emilkarimov/G3_airhockey/README.md

AIR HOCKEY TABLE GAME - ECE532 April 13th 2017

The folder structure for this github is as follows:
     Docs contains the final presentation, final report, block diagram, and video demo.
     src contains the project files and IP used. 

     For details about this project, please refer to the documentation.
     For a detailed breakdown of this tree, please see the corresponding section in the final report.
     To start this project in Vivado, navigate to src/image_proc/NexysVideo-master_v3/Projects/hdmi/proj/hdmi.xpr

Authors
     Richard Lin
     Jashva Rafique
     Emil Karimov
     Prabhnoor Kainth
