emilkarimov/G3_airhockey/src/image_proc/NexysVideo-master_v3/Projects/hdmi/proj/hdmi.runs/impl_1/_init_design.begin.rst

<?xml version="1.0"?>
<ProcessHandle Version="1" Minor="0">
    <Process Command=".planAhead." Owner="dezfoul2" Host="SFB520WS14" Pid="3860">
    </Process>
</ProcessHandle>
