emilkarimov/G3_airhockey/src/image_proc/packaged-joystick/ip_repo/edit_packaged_joystick_v1_0.runs/synth_1/.vivado.begin.rst

<?xml version="1.0"?>
<ProcessHandle Version="1" Minor="0">
    <Process Command="vivado.bat" Owner="Jash" Host="JASH-PC" Pid="10768">
    </Process>
</ProcessHandle>
