emilkarimov/G3_airhockey/src/image_proc/NexysVideo-master_v3/Projects/hdmi/proj/hdmi.runs/impl_1/.vivado.begin.rst

<?xml version="1.0"?>
<ProcessHandle Version="1" Minor="0">
    <Process Command="vivado.bat" Owner="richa" Host="RLIN-GAMING" Pid="13996">
    </Process>
</ProcessHandle>
