emilkarimov/G3_airhockey/src/image_proc/NexysVideo-master_v3/Projects/hdmi/proj/hdmi.runs/impl_1/_vivado.begin.rst

<?xml version="1.0"?>
<ProcessHandle Version="1" Minor="0">
    <Process Command="vivado.bat" Owner="dezfoul2" Host="SFB520WS14" Pid="3720">
    </Process>
</ProcessHandle>
