emilkarimov/G3_airhockey/docs/hdmi.pdf

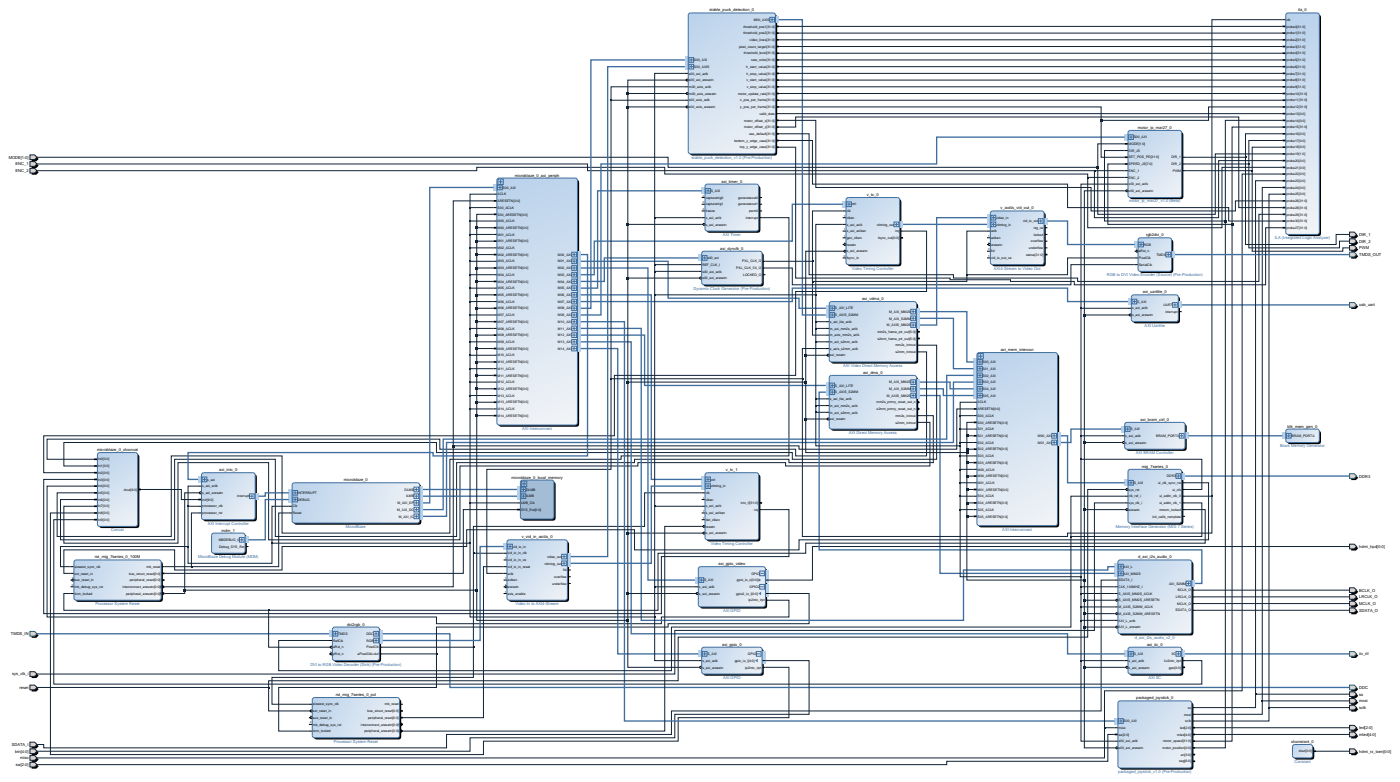
[picture p21: page 1]
BCLK_O; DDC; DDR3; DIR_1 DIR_2; ENC_1 ENC_2; LRCLK_O MCLK_O; MODE[1:0]; PWM; SDATA_I; SDATA_O; TMDS_IN; TMDS_OUT; axi_bram_ctrl_0; S_AXI s_axi_aclk; BRAM_PORTA; s_axi_aresetn; axi_dma_0; S_AXI_LITE; M_AXI_MM2S M_AXI_S2MM; M_AXIS_MM2S; S_AXIS_S2MM; s_axi_lite_aclk m_axi_mm2s_aclk m_axi_s2mm_aclk axi_resetn; mm2s_prmry_reset_out_n; s2mm_prmry_reset_out_n mm2s_introut s2mm_introut; axi_dynclk_0; s00_axi REF_CLK_I; PXL_CLK_O; PXL_CLK_5X_O; LOCKED_O; s00_axi_aclk; s00_axi_aresetn; axi_gpio_video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

S00_AXI ACLK ARESETN[0:0] S00_ACLK S00_ARESETN[0:0] M00_ACLK M00_ARESETN[0:0] M01_ACLK M01_ARESETN[0:0] M02_ACLK M02_ARESETN[0:0] M03_ACLK M03_ARESETN[0:0] M04_ACLK M04_ARESETN[0:0] M05_ACLK M05_ARESETN[0:0] M06_ACLK M06_ARESETN[0:0] M07_ACLK M07_ARESETN[0:0] M08_ACLK M08_ARESETN[0:0] M09_ACLK M09_ARESETN[0:0] M10_ACLK M10_ARESETN[0:0] M11_ACLK M11_ARESETN[0:0] M12_ACLK M12_ARESETN[0:0] M13_ACLK M13_ARESETN[0:0] M14_ACLK M14_ARESETN[0:0] M00_AXI M01_AXI M02_AXI M03_AXI M04_AXI M05_AXI M06_AXI M07_AXI M08_AXI M09_AXI M10_AXI M11_AXI M12_AXI M13_AXI M14_AXI | axi_timer_0

ILA (Integrated Logic Analyzer)

Video Timing Controller

AXI4-Stream to Video Out

Dynamic Clock Generator (Pre-Production)

RGB to DVI Video Encoder (Source) (Pre-Production)

AXI Video Direct Memory Access

AXI Direct Memory Access

AXI BRAM Controller

Block Memory Generator

AXI Interrupt Controller
mdm_1

Memory Interface Generator (MIG 7 Series)

MicroBlaze Debug Module (MDM)

Processor System Reset

Video In to AXI4-Stream

DVI to RGB Video Decoder (Sink) (Pre-Production)

ss mosi sclk

led[2:0] mled[4:0] motor_speed[31:0] motor_position[0:0] an[3:0] seg[6:0]
