emilkarimov/G3_airhockey/src/image_proc/NexysVideo-master_v3/Projects/hdmi/proj/hdmi.runs/synth_1/.Xil/hdmi_wrapper_propImpl.xdc

set_property SRC_FILE_INFO {cfile:d:/Xilinx/Projects/image_proc/NexysVideo-master_v3/Projects/hdmi/proj/hdmi.srcs/sources_1/bd/hdmi/ip/hdmi_mdm_1_0/hdmi_mdm_1_0.xdc rfile:../../../hdmi.srcs/sources_1/bd/hdmi/ip/hdmi_mdm_1_0/hdmi_mdm_1_0.xdc id:1 order:EARLY scoped_inst:hdmi_i/mdm_1/U0} [current_design]
set_property SRC_FILE_INFO {cfile:d:/Xilinx/Projects/image_proc/NexysVideo-master_v3/Projects/hdmi/proj/hdmi.srcs/sources_1/bd/hdmi/ip/hdmi_microblaze_0_0/hdmi_microblaze_0_0.xdc rfile:../../../hdmi.srcs/sources_1/bd/hdmi/ip/hdmi_microblaze_0_0/hdmi_microblaze_0_0.xdc id:2 order:EARLY scoped_inst:hdmi_i/microblaze_0/U0} [current_design]
set_property SRC_FILE_INFO {cfile:d:/Xilinx/Projects/image_proc/NexysVideo-master_v3/Projects/hdmi/proj/hdmi.srcs/sources_1/bd/hdmi/ip/hdmi_mig_7series_0_0/hdmi_mig_7series_0_0/user_design/constraints/hdmi_mig_7series_0_0.xdc rfile:../../../hdmi.srcs/sources_1/bd/hdmi/ip/hdmi_mig_7series_0_0/hdmi_mig_7series_0_0/user_design/constraints/hdmi_mig_7series_0_0.xdc id:3 order:EARLY scoped_inst:hdmi_i/mig_7series_0} [current_design]
set_property SRC_FILE_INFO {cfile:D:/Xilinx/Projects/image_proc/NexysVideo-master_v3/Projects/hdmi/src/constraints/NexysVideo_Master.xdc rfile:../../../../src/constraints/NexysVideo_Master.xdc id:4} [current_design]
set_property SRC_FILE_INFO {cfile:d:/Xilinx/Projects/image_proc/NexysVideo-master_v3/Projects/hdmi/proj/hdmi.srcs/sources_1/bd/hdmi/ip/hdmi_v_tc_0_0/hdmi_v_tc_0_0_clocks.xdc rfile:../../../hdmi.srcs/sources_1/bd/hdmi/ip/hdmi_v_tc_0_0/hdmi_v_tc_0_0_clocks.xdc id:5 order:LATE scoped_inst:hdmi_i/v_tc_0/U0} [current_design]
set_property SRC_FILE_INFO {cfile:d:/Xilinx/Projects/image_proc/NexysVideo-master_v3/Projects/hdmi/proj/hdmi.srcs/sources_1/bd/hdmi/ip/hdmi_v_tc_1_0/hdmi_v_tc_1_0_clocks.xdc rfile:../../../hdmi.srcs/sources_1/bd/hdmi/ip/hdmi_v_tc_1_0/hdmi_v_tc_1_0_clocks.xdc id:6 order:LATE scoped_inst:hdmi_i/v_tc_1/U0} [current_design]
set_property SRC_FILE_INFO {cfile:d:/Xilinx/Projects/image_proc/NexysVideo-master_v3/Projects/hdmi/proj/hdmi.srcs/sources_1/bd/hdmi/ip/hdmi_v_vid_in_axi4s_0_0/hdmi_v_vid_in_axi4s_0_0_clocks.xdc rfile:../../../hdmi.srcs/sources_1/bd/hdmi/ip/hdmi_v_vid_in_axi4s_0_0/hdmi_v_vid_in_axi4s_0_0_clocks.xdc id:7 order:LATE scoped_inst:hdmi_i/v_vid_in_axi4s_0/inst} [current_design]
set_property SRC_FILE_INFO {cfile:d:/Xilinx/Projects/image_proc/NexysVideo-master_v3/Projects/hdmi/proj/hdmi.srcs/sources_1/bd/hdmi/ip/hdmi_d_axi_i2s_audio_0_0/src/fifo_32/fifo_32/fifo_32_clocks.xdc rfile:../../../hdmi.srcs/sources_1/bd/hdmi/ip/hdmi_d_axi_i2s_audio_0_0/src/fifo_32/fifo_32/fifo_32_clocks.xdc id:8 order:LATE scoped_inst:hdmi_i/d_axi_i2s_audio_0/U0/d_axi_i2s_audio_v2_0_AXI_L_inst/Inst_I2sCtl/Inst_I2sTxFifo/U0} [current_design]
set_property SRC_FILE_INFO {cfile:d:/Xilinx/Projects/image_proc/NexysVideo-master_v3/Projects/hdmi/proj/hdmi.srcs/sources_1/bd/hdmi/ip/hdmi_d_axi_i2s_audio_0_0/src/fifo_32/fifo_32/fifo_32_clocks.xdc rfile:../../../hdmi.srcs/sources_1/bd/hdmi/ip/hdmi_d_axi_i2s_audio_0_0/src/fifo_32/fifo_32/fifo_32_clocks.xdc id:9 order:LATE scoped_inst:hdmi_i/d_axi_i2s_audio_0/U0/d_axi_i2s_audio_v2_0_AXI_L_inst/Inst_I2sCtl/Inst_I2sRxFifo/U0} [current_design]
set_property SRC_FILE_INFO {cfile:d:/Xilinx/Projects/image_proc/NexysVideo-master_v3/Projects/hdmi/proj/hdmi.srcs/sources_1/bd/hdmi/ip/hdmi_d_axi_i2s_audio_0_0/src/fifo_4/fifo_4/fifo_4_clocks.xdc rfile:../../../hdmi.srcs/sources_1/bd/hdmi/ip/hdmi_d_axi_i2s_audio_0_0/src/fifo_4/fifo_4/fifo_4_clocks.xdc id:10 order:LATE scoped_inst:hdmi_i/d_axi_i2s_audio_0/U0/d_axi_i2s_audio_v2_0_AXI_L_inst/Inst_I2sCtl/Inst_Sampling/U0} [current_design]
set_property src_info {type:SCOPED_XDC file:1 line:57 export:INPUT save:INPUT read:READ} [current_design]
set_ip_msg_config -idlist { CDC-1 CDCM-1 REQP-1851 TIMING-2 TIMING-4 TIMING-9 TIMING-10 TIMING-14 }
set_property src_info {type:SCOPED_XDC file:2 line:2 export:INPUT save:INPUT read:READ} [current_design]
set_ip_msg_config -idlist { DPOP-3 PDCN-1569 CDC-1 CDC-4 CDC-7 TIMING-9 TIMING-10 DPIP-2 DPOP-4 }
set_property src_info {type:SCOPED_XDC file:3 line:48 export:INPUT save:INPUT read:READ} [current_design]
set_property PACKAGE_PIN G2 [get_ports {ddr3_dq[0]}]
set_property src_info {type:SCOPED_XDC file:3 line:54 export:INPUT save:INPUT read:READ} [current_design]
set_property PACKAGE_PIN H4 [get_ports {ddr3_dq[1]}]
set_property src_info {type:SCOPED_XDC file:3 line:60 export:INPUT save:INPUT read:READ} [current_design]
set_property PACKAGE_PIN H5 [get_ports {ddr3_dq[2]}]
set_property src_info {type:SCOPED_XDC file:3 line:66 export:INPUT save:INPUT read:READ} [current_design]
set_property PACKAGE_PIN J1 [get_ports {ddr3_dq[3]}]
set_property src_info {type:SCOPED_XDC file:3 line:72 export:INPUT save:INPUT read:READ} [current_design]
set_property PACKAGE_PIN K1 [get_ports {ddr3_dq[4]}]
set_property src_info {type:SCOPED_XDC file:3 line:78 export:INPUT save:INPUT read:READ} [current_design]
set_property PACKAGE_PIN H3 [get_ports {ddr3_dq[5]}]
set_property src_info {type:SCOPED_XDC file:3 line:84 export:INPUT save:INPUT read:READ} [current_design]
set_property PACKAGE_PIN H2 [get_ports {ddr3_dq[6]}]
set_property src_info {type:SCOPED_XDC file:3 line:90 export:INPUT save:INPUT read:READ} [current_design]
set_property PACKAGE_PIN J5 [get_ports {ddr3_dq[7]}]
set_property src_info {type:SCOPED_XDC file:3 line:96 export:INPUT save:INPUT read:READ} [current_design]
set_property PACKAGE_PIN E3 [get_ports {ddr3_dq[8]}]
set_property src_info {type:SCOPED_XDC file:3 line:102 export:INPUT save:INPUT read:READ} [current_design]
set_property PACKAGE_PIN B2 [get_ports {ddr3_dq[9]}]
set_property src_info {type:SCOPED_XDC file:3 line:108 export:INPUT save:INPUT read:READ} [current_design]
set_property PACKAGE_PIN F3 [get_ports {ddr3_dq[10]}]
set_property src_info {type:SCOPED_XDC file:3 line:114 export:INPUT save:INPUT read:READ} [current_design]
set_property PACKAGE_PIN D2 [get_ports {ddr3_dq[11]}]
set_property src_info {type:SCOPED_XDC file:3 line:120 export:INPUT save:INPUT read:READ} [current_design]
set_property PACKAGE_PIN C2 [get_ports {ddr3_dq[12]}]
set_property src_info {type:SCOPED_XDC file:3 line:126 export:INPUT save:INPUT read:READ} [current_design]
set_property PACKAGE_PIN A1 [get_ports {ddr3_dq[13]}]
set_property src_info {type:SCOPED_XDC file:3 line:132 export:INPUT save:INPUT read:READ} [current_design]
set_property PACKAGE_PIN E2 [get_ports {ddr3_dq[14]}]
set_property src_info {type:SCOPED_XDC file:3 line:138 export:INPUT save:INPUT read:READ} [current_design]
set_property PACKAGE_PIN B1 [get_ports {ddr3_dq[15]}]
set_property src_info {type:SCOPED_XDC file:3 line:143 export:INPUT save:INPUT read:READ} [current_design]
set_property PACKAGE_PIN P6 [get_ports {ddr3_addr[14]}]
set_property src_info {type:SCOPED_XDC file:3 line:148 export:INPUT save:INPUT read:READ} [current_design]
set_property PACKAGE_PIN P2 [get_ports {ddr3_addr[13]}]
set_property src_info {type:SCOPED_XDC file:3 line:153 export:INPUT save:INPUT read:READ} [current_design]
set_property PACKAGE_PIN N4 [get_ports {ddr3_addr[12]}]
set_property src_info {type:SCOPED_XDC file:3 line:158 export:INPUT save:INPUT read:READ} [current_design]
set_property PACKAGE_PIN N5 [get_ports {ddr3_addr[11]}]
set_property src_info {type:SCOPED_XDC file:3 line:163 export:INPUT save:INPUT read:READ} [current_design]
set_property PACKAGE_PIN L5 [get_ports {ddr3_addr[10]}]
set_property src_info {type:SCOPED_XDC file:3 line:168 export:INPUT save:INPUT read:READ} [current_design]
set_property PACKAGE_PIN R1 [get_ports {ddr3_addr[9]}]
set_property src_info {type:SCOPED_XDC file:3 line:173 export:INPUT save:INPUT read:READ} [current_design]
set_property PACKAGE_PIN M6 [get_ports {ddr3_addr[8]}]
set_property src_info {type:SCOPED_XDC file:3 line:178 export:INPUT save:INPUT read:READ} [current_design]
set_property PACKAGE_PIN N2 [get_ports {ddr3_addr[7]}]
set_property src_info {type:SCOPED_XDC file:3 line:183 export:INPUT save:INPUT read:READ} [current_design]
set_property PACKAGE_PIN N3 [get_ports {ddr3_addr[6]}]
set_property src_info {type:SCOPED_XDC file:3 line:188 export:INPUT save:INPUT read:READ} [current_design]
set_property PACKAGE_PIN P1 [get_ports {ddr3_addr[5]}]
set_property src_info {type:SCOPED_XDC file:3 line:193 export:INPUT save:INPUT read:READ} [current_design]
set_property PACKAGE_PIN L6 [get_ports {ddr3_addr[4]}]
set_property src_info {type:SCOPED_XDC file:3 line:198 export:INPUT save:INPUT read:READ} [current_design]
set_property PACKAGE_PIN M1 [get_ports {ddr3_addr[3]}]
set_property src_info {type:SCOPED_XDC file:3 line:203 export:INPUT save:INPUT read:READ} [current_design]
set_property PACKAGE_PIN M3 [get_ports {ddr3_addr[2]}]
set_property src_info {type:SCOPED_XDC file:3 line:208 export:INPUT save:INPUT read:READ} [current_design]
set_property PACKAGE_PIN M5 [get_ports {ddr3_addr[1]}]
set_property src_info {type:SCOPED_XDC file:3 line:213 export:INPUT save:INPUT read:READ} [current_design]
set_property PACKAGE_PIN M2 [get_ports {ddr3_addr[0]}]
set_property src_info {type:SCOPED_XDC file:3 line:218 export:INPUT save:INPUT read:READ} [current_design]
set_property PACKAGE_PIN L4 [get_ports {ddr3_ba[2]}]
set_property src_info {type:SCOPED_XDC file:3 line:223 export:INPUT save:INPUT read:READ} [current_design]
set_property PACKAGE_PIN K6 [get_ports {ddr3_ba[1]}]
set_property src_info {type:SCOPED_XDC file:3 line:228 export:INPUT save:INPUT read:READ} [current_design]
set_property PACKAGE_PIN L3 [get_ports {ddr3_ba[0]}]
set_property src_info {type:SCOPED_XDC file:3 line:233 export:INPUT save:INPUT read:READ} [current_design]
set_property PACKAGE_PIN J4 [get_ports {ddr3_ras_n}]
set_property src_info {type:SCOPED_XDC file:3 line:238 export:INPUT save:INPUT read:READ} [current_design]
set_property PACKAGE_PIN K3 [get_ports {ddr3_cas_n}]
set_property src_info {type:SCOPED_XDC file:3 line:243 export:INPUT save:INPUT read:READ} [current_design]
set_property PACKAGE_PIN L1 [get_ports {ddr3_we_n}]
set_property src_info {type:SCOPED_XDC file:3 line:248 export:INPUT save:INPUT read:READ} [current_design]
set_property PACKAGE_PIN G1 [get_ports {ddr3_reset_n}]
set_property src_info {type:SCOPED_XDC file:3 line:253 export:INPUT save:INPUT read:READ} [current_design]
set_property PACKAGE_PIN J6 [get_ports {ddr3_cke[0]}]
set_property src_info {type:SCOPED_XDC file:3 line:258 export:INPUT save:INPUT read:READ} [current_design]
set_property PACKAGE_PIN K4 [get_ports {ddr3_odt[0]}]
set_property src_info {type:SCOPED_XDC file:3 line:263 export:INPUT save:INPUT read:READ} [current_design]
set_property PACKAGE_PIN G3 [get_ports {ddr3_dm[0]}]
set_property src_info {type:SCOPED_XDC file:3 line:268 export:INPUT save:INPUT read:READ} [current_design]
set_property PACKAGE_PIN F1 [get_ports {ddr3_dm[1]}]
set_property src_info {type:SCOPED_XDC file:3 line:272 export:INPUT save:INPUT read:READ} [current_design]
set_property PACKAGE_PIN R4 [get_ports {sys_clk_i}]
set_property src_info {type:SCOPED_XDC file:3 line:278 export:INPUT save:INPUT read:READ} [current_design]
set_property PACKAGE_PIN K2 [get_ports {ddr3_dqs_p[0]}]
set_property src_info {type:SCOPED_XDC file:3 line:284 export:INPUT save:INPUT read:READ} [current_design]
set_property PACKAGE_PIN J2 [get_ports {ddr3_dqs_n[0]}]
set_property src_info {type:SCOPED_XDC file:3 line:290 export:INPUT save:INPUT read:READ} [current_design]
set_property PACKAGE_PIN E1 [get_ports {ddr3_dqs_p[1]}]
set_property src_info {type:SCOPED_XDC file:3 line:296 export:INPUT save:INPUT read:READ} [current_design]
set_property PACKAGE_PIN D1 [get_ports {ddr3_dqs_n[1]}]
set_property src_info {type:SCOPED_XDC file:3 line:301 export:INPUT save:INPUT read:READ} [current_design]
set_property PACKAGE_PIN P5 [get_ports {ddr3_ck_p[0]}]
set_property src_info {type:SCOPED_XDC file:3 line:306 export:INPUT save:INPUT read:READ} [current_design]
set_property PACKAGE_PIN P4 [get_ports {ddr3_ck_n[0]}]
set_property src_info {type:SCOPED_XDC file:3 line:311 export:INPUT save:INPUT read:READ} [current_design]
set_property LOC PHASER_OUT_PHY_X1Y13 [get_cells  -hier -filter {NAME =~ */ddr_phy_4lanes_0.u_ddr_phy_4lanes/ddr_byte_lane_B.ddr_byte_lane_B/phaser_out}]
set_property src_info {type:SCOPED_XDC file:3 line:312 export:INPUT save:INPUT read:READ} [current_design]
set_property LOC PHASER_OUT_PHY_X1Y12 [get_cells  -hier -filter {NAME =~ */ddr_phy_4lanes_0.u_ddr_phy_4lanes/ddr_byte_lane_A.ddr_byte_lane_A/phaser_out}]
set_property src_info {type:SCOPED_XDC file:3 line:313 export:INPUT save:INPUT read:READ} [current_design]
set_property LOC PHASER_OUT_PHY_X1Y15 [get_cells  -hier -filter {NAME =~ */ddr_phy_4lanes_0.u_ddr_phy_4lanes/ddr_byte_lane_D.ddr_byte_lane_D/phaser_out}]
set_property src_info {type:SCOPED_XDC file:3 line:314 export:INPUT save:INPUT read:READ} [current_design]
set_property LOC PHASER_OUT_PHY_X1Y14 [get_cells  -hier -filter {NAME =~ */ddr_phy_4lanes_0.u_ddr_phy_4lanes/ddr_byte_lane_C.ddr_byte_lane_C/phaser_out}]
set_property src_info {type:SCOPED_XDC file:3 line:318 export:INPUT save:INPUT read:READ} [current_design]
set_property LOC PHASER_IN_PHY_X1Y15 [get_cells  -hier -filter {NAME =~ */ddr_phy_4lanes_0.u_ddr_phy_4lanes/ddr_byte_lane_D.ddr_byte_lane_D/phaser_in_gen.phaser_in}]
set_property src_info {type:SCOPED_XDC file:3 line:319 export:INPUT save:INPUT read:READ} [current_design]
set_property LOC PHASER_IN_PHY_X1Y14 [get_cells  -hier -filter {NAME =~ */ddr_phy_4lanes_0.u_ddr_phy_4lanes/ddr_byte_lane_C.ddr_byte_lane_C/phaser_in_gen.phaser_in}]
set_property src_info {type:SCOPED_XDC file:3 line:323 export:INPUT save:INPUT read:READ} [current_design]
set_property LOC OUT_FIFO_X1Y13 [get_cells  -hier -filter {NAME =~ */ddr_phy_4lanes_0.u_ddr_phy_4lanes/ddr_byte_lane_B.ddr_byte_lane_B/out_fifo}]
set_property src_info {type:SCOPED_XDC file:3 line:324 export:INPUT save:INPUT read:READ} [current_design]
set_property LOC OUT_FIFO_X1Y12 [get_cells  -hier -filter {NAME =~ */ddr_phy_4lanes_0.u_ddr_phy_4lanes/ddr_byte_lane_A.ddr_byte_lane_A/out_fifo}]
set_property src_info {type:SCOPED_XDC file:3 line:325 export:INPUT save:INPUT read:READ} [current_design]
set_property LOC OUT_FIFO_X1Y15 [get_cells  -hier -filter {NAME =~ */ddr_phy_4lanes_0.u_ddr_phy_4lanes/ddr_byte_lane_D.ddr_byte_lane_D/out_fifo}]
set_property src_info {type:SCOPED_XDC file:3 line:326 export:INPUT save:INPUT read:READ} [current_design]
set_property LOC OUT_FIFO_X1Y14 [get_cells  -hier -filter {NAME =~ */ddr_phy_4lanes_0.u_ddr_phy_4lanes/ddr_byte_lane_C.ddr_byte_lane_C/out_fifo}]
set_property src_info {type:SCOPED_XDC file:3 line:328 export:INPUT save:INPUT read:READ} [current_design]
set_property LOC IN_FIFO_X1Y15 [get_cells  -hier -filter {NAME =~ */ddr_phy_4lanes_0.u_ddr_phy_4lanes/ddr_byte_lane_D.ddr_byte_lane_D/in_fifo_gen.in_fifo}]
set_property src_info {type:SCOPED_XDC file:3 line:329 export:INPUT save:INPUT read:READ} [current_design]
set_property LOC IN_FIFO_X1Y14 [get_cells  -hier -filter {NAME =~ */ddr_phy_4lanes_0.u_ddr_phy_4lanes/ddr_byte_lane_C.ddr_byte_lane_C/in_fifo_gen.in_fifo}]
set_property src_info {type:SCOPED_XDC file:3 line:331 export:INPUT save:INPUT read:READ} [current_design]
set_property LOC PHY_CONTROL_X1Y3 [get_cells  -hier -filter {NAME =~ */ddr_phy_4lanes_0.u_ddr_phy_4lanes/phy_control_i}]
set_property src_info {type:SCOPED_XDC file:3 line:333 export:INPUT save:INPUT read:READ} [current_design]
set_property LOC PHASER_REF_X1Y3 [get_cells  -hier -filter {NAME =~ */ddr_phy_4lanes_0.u_ddr_phy_4lanes/phaser_ref_i}]
set_property src_info {type:SCOPED_XDC file:3 line:335 export:INPUT save:INPUT read:READ} [current_design]
set_property LOC OLOGIC_X1Y193 [get_cells  -hier -filter {NAME =~ */ddr_phy_4lanes_0.u_ddr_phy_4lanes/ddr_byte_lane_D.ddr_byte_lane_D/ddr_byte_group_io/*slave_ts}]
set_property src_info {type:SCOPED_XDC file:3 line:336 export:INPUT save:INPUT read:READ} [current_design]
set_property LOC OLOGIC_X1Y181 [get_cells  -hier -filter {NAME =~ */ddr_phy_4lanes_0.u_ddr_phy_4lanes/ddr_byte_lane_C.ddr_byte_lane_C/ddr_byte_group_io/*slave_ts}]
set_property src_info {type:SCOPED_XDC file:3 line:338 export:INPUT save:INPUT read:READ} [current_design]
set_property LOC PLLE2_ADV_X1Y3 [get_cells -hier -filter {NAME =~ */u_ddr3_infrastructure/plle2_i}]
set_property src_info {type:SCOPED_XDC file:3 line:339 export:INPUT save:INPUT read:READ} [current_design]
set_property LOC MMCME2_ADV_X1Y3 [get_cells -hier -filter {NAME =~ */u_ddr3_infrastructure/gen_ui_extra_clocks.mmcm_i}]
set_property src_info {type:SCOPED_XDC file:3 line:355 export:INPUT save:INPUT read:READ} [current_design]
set_max_delay -datapath_only -from [get_cells -hier -filter {NAME =~ *temp_mon_enabled.u_tempmon/* && IS_SEQUENTIAL}] -to [get_cells -hier -filter {NAME =~ *temp_mon_enabled.u_tempmon/device_temp_sync_r1*}] 20
set_property src_info {type:SCOPED_XDC file:3 line:356 export:INPUT save:INPUT read:READ} [current_design]
set_max_delay -from [get_cells -hier *rstdiv0_sync_r1_reg*] -to [get_pins -filter {NAME =~ */RESET} -of [get_cells -hier -filter {REF_NAME == PHY_CONTROL}]] -datapath_only 5
set_property src_info {type:SCOPED_XDC file:3 line:359 export:INPUT save:INPUT read:READ} [current_design]
set_max_delay -datapath_only -from [get_cells -hier -filter {NAME =~ *ddr3_infrastructure/rstdiv0_sync_r1_reg*}] -to [get_cells -hier -filter {NAME =~ *temp_mon_enabled.u_tempmon/xadc_supplied_temperature.rst_r1*}] 20
set_property src_info {type:XDC file:4 line:8 export:INPUT save:INPUT read:READ} [current_design]
set_property -dict { PACKAGE_PIN R4    IOSTANDARD LVCMOS33 } [get_ports { sys_clk_i }]; #IO_L13P_T2_MRCC_34 Sch=sysclk
set_property src_info {type:XDC file:4 line:13 export:INPUT save:INPUT read:READ} [current_design]
set_property -dict { PACKAGE_PIN T14   IOSTANDARD LVCMOS25 } [get_ports { mled[0] }]; #IO_L15P_T2_DQS_13 Sch=led[0]
set_property src_info {type:XDC file:4 line:14 export:INPUT save:INPUT read:READ} [current_design]
set_property -dict { PACKAGE_PIN T15   IOSTANDARD LVCMOS25 } [get_ports { mled[1] }]; #IO_L15N_T2_DQS_13 Sch=led[1]
set_property src_info {type:XDC file:4 line:15 export:INPUT save:INPUT read:READ} [current_design]
set_property -dict { PACKAGE_PIN T16   IOSTANDARD LVCMOS25 } [get_ports { mled[2] }]; #IO_L17P_T2_13 Sch=led[2]
set_property src_info {type:XDC file:4 line:16 export:INPUT save:INPUT read:READ} [current_design]
set_property -dict { PACKAGE_PIN U16   IOSTANDARD LVCMOS25 } [get_ports { mled[3] }]; #IO_L17N_T2_13 Sch=led[3]
set_property src_info {type:XDC file:4 line:17 export:INPUT save:INPUT read:READ} [current_design]
set_property -dict { PACKAGE_PIN V15   IOSTANDARD LVCMOS25 } [get_ports { mled[4] }]; #IO_L14N_T2_SRCC_13 Sch=led[4]
set_property src_info {type:XDC file:4 line:18 export:INPUT save:INPUT read:READ} [current_design]
set_property -dict { PACKAGE_PIN W16   IOSTANDARD LVCMOS25 } [get_ports { led[0] }]; #IO_L16N_T2_13 Sch=led[5]
set_property src_info {type:XDC file:4 line:19 export:INPUT save:INPUT read:READ} [current_design]
set_property -dict { PACKAGE_PIN W15   IOSTANDARD LVCMOS25 } [get_ports { led[1] }]; #IO_L16P_T2_13 Sch=led[6]
set_property src_info {type:XDC file:4 line:20 export:INPUT save:INPUT read:READ} [current_design]
set_property -dict { PACKAGE_PIN Y13   IOSTANDARD LVCMOS25 } [get_ports { led[2] }]; #IO_L5P_T0_13 Sch=led[7]
set_property src_info {type:XDC file:4 line:24 export:INPUT save:INPUT read:READ} [current_design]
set_property -dict { PACKAGE_PIN B22 IOSTANDARD LVCMOS12 } [get_ports { btn[4] }]; #IO_L20N_T3_16 Sch=btnc
set_property src_info {type:XDC file:4 line:25 export:INPUT save:INPUT read:READ} [current_design]
set_property -dict { PACKAGE_PIN D22 IOSTANDARD LVCMOS12 } [get_ports { btn[3] }]; #IO_L22N_T3_16 Sch=btnd
set_property src_info {type:XDC file:4 line:26 export:INPUT save:INPUT read:READ} [current_design]
set_property -dict { PACKAGE_PIN C22 IOSTANDARD LVCMOS12 } [get_ports { btn[2] }]; #IO_L20P_T3_16 Sch=btnl
set_property src_info {type:XDC file:4 line:27 export:INPUT save:INPUT read:READ} [current_design]
set_property -dict { PACKAGE_PIN D14 IOSTANDARD LVCMOS12 } [get_ports { btn[1] }]; #IO_L6P_T0_16 Sch=btnr
set_property src_info {type:XDC file:4 line:28 export:INPUT save:INPUT read:READ} [current_design]
set_property -dict { PACKAGE_PIN F15 IOSTANDARD LVCMOS12 } [get_ports { btn[0] }]; #IO_0_16 Sch=btnu
set_property src_info {type:XDC file:4 line:33 export:INPUT save:INPUT read:READ} [current_design]
set_property -dict { PACKAGE_PIN E22  IOSTANDARD LVCMOS12} [get_ports { sw[0] }]; #IO_L22P_T3_16 Sch=sw[0]
set_property src_info {type:XDC file:4 line:34 export:INPUT save:INPUT read:READ} [current_design]
set_property -dict { PACKAGE_PIN F21  IOSTANDARD LVCMOS12} [get_ports { sw[1] }]; #IO_25_16 Sch=sw[1]
set_property src_info {type:XDC file:4 line:35 export:INPUT save:INPUT read:READ} [current_design]
set_property -dict { PACKAGE_PIN G21  IOSTANDARD LVCMOS12} [get_ports { sw[2] }]; #IO_L24P_T3_16 Sch=sw[2]
set_property src_info {type:XDC file:4 line:36 export:INPUT save:INPUT read:READ} [current_design]
set_property -dict { PACKAGE_PIN G22  IOSTANDARD LVCMOS12} [get_ports { RESETN }]; #IO_L24N_T3_16 Sch=sw[3]
set_property src_info {type:XDC file:4 line:37 export:INPUT save:INPUT read:READ} [current_design]
set_property -dict { PACKAGE_PIN H17  IOSTANDARD LVCMOS12} [get_ports { GO }]; #IO_L6P_T0_15 Sch=sw[4]
set_property src_info {type:XDC file:4 line:38 export:INPUT save:INPUT read:READ} [current_design]
set_property -dict { PACKAGE_PIN J16  IOSTANDARD LVCMOS12} [get_ports { MODE[0] }]; #IO_0_15 Sch=sw[5]
set_property src_info {type:XDC file:4 line:39 export:INPUT save:INPUT read:READ} [current_design]
set_property -dict { PACKAGE_PIN K13  IOSTANDARD LVCMOS12} [get_ports { MODE[1] }]; #IO_L19P_T3_A22_15 Sch=sw[6]
set_property src_info {type:XDC file:4 line:40 export:INPUT save:INPUT read:READ} [current_design]
set_property -dict { PACKAGE_PIN M17  IOSTANDARD LVCMOS12} [get_ports { rst }]; #IO_25_15 Sch=sw[7]
set_property src_info {type:XDC file:4 line:54 export:INPUT save:INPUT read:READ} [current_design]
set_property -dict { PACKAGE_PIN W4    IOSTANDARD TMDS_33     } [get_ports { TMDS_IN_clk_n }]; #IO_L12N_T1_MRCC_34 Sch=hdmi_rx_clk_n
set_property src_info {type:XDC file:4 line:55 export:INPUT save:INPUT read:READ} [current_design]
set_property -dict { PACKAGE_PIN V4    IOSTANDARD TMDS_33     } [get_ports { TMDS_IN_clk_p }]; #IO_L12P_T1_MRCC_34 Sch=hdmi_rx_clk_p
set_property src_info {type:XDC file:4 line:57 export:INPUT save:INPUT read:READ} [current_design]
set_property -dict { PACKAGE_PIN AB12  IOSTANDARD LVCMOS25 } [get_ports { hdmi_hpd }]; #IO_L7N_T1_13 Sch=hdmi_rx_hpa
set_property src_info {type:XDC file:4 line:58 export:INPUT save:INPUT read:READ} [current_design]
set_property -dict { PACKAGE_PIN Y4    IOSTANDARD LVCMOS33 } [get_ports { ddc_scl_io }]; #IO_L11P_T1_SRCC_34 Sch=hdmi_rx_scl
set_property src_info {type:XDC file:4 line:59 export:INPUT save:INPUT read:READ} [current_design]
set_property -dict { PACKAGE_PIN AB5   IOSTANDARD LVCMOS33 } [get_ports { ddc_sda_io }]; #IO_L10N_T1_34 Sch=hdmi_rx_sda
set_property src_info {type:XDC file:4 line:60 export:INPUT save:INPUT read:READ} [current_design]
set_property -dict { PACKAGE_PIN R3    IOSTANDARD LVCMOS33 } [get_ports { hdmi_rx_txen }]; #IO_L3P_T0_DQS_34 Sch=hdmi_rx_txen
set_property src_info {type:XDC file:4 line:61 export:INPUT save:INPUT read:READ} [current_design]
set_property -dict { PACKAGE_PIN AA3   IOSTANDARD TMDS_33     } [get_ports { TMDS_IN_data_n[0] }]; #IO_L9N_T1_DQS_34 Sch=hdmi_rx_n[0]
set_property src_info {type:XDC file:4 line:62 export:INPUT save:INPUT read:READ} [current_design]
set_property -dict { PACKAGE_PIN Y3    IOSTANDARD TMDS_33     } [get_ports { TMDS_IN_data_p[0] }]; #IO_L9P_T1_DQS_34 Sch=hdmi_rx_p[0]
set_property src_info {type:XDC file:4 line:63 export:INPUT save:INPUT read:READ} [current_design]
set_property -dict { PACKAGE_PIN Y2    IOSTANDARD TMDS_33     } [get_ports { TMDS_IN_data_n[1] }]; #IO_L4N_T0_34 Sch=hdmi_rx_n[1]
set_property src_info {type:XDC file:4 line:64 export:INPUT save:INPUT read:READ} [current_design]
set_property -dict { PACKAGE_PIN W2    IOSTANDARD TMDS_33     } [get_ports { TMDS_IN_data_p[1] }]; #IO_L4P_T0_34 Sch=hdmi_rx_p[1]
set_property src_info {type:XDC file:4 line:65 export:INPUT save:INPUT read:READ} [current_design]
set_property -dict { PACKAGE_PIN V2    IOSTANDARD TMDS_33     } [get_ports { TMDS_IN_data_n[2] }]; #IO_L2N_T0_34 Sch=hdmi_rx_n[2]
set_property src_info {type:XDC file:4 line:66 export:INPUT save:INPUT read:READ} [current_design]
set_property -dict { PACKAGE_PIN U2    IOSTANDARD TMDS_33     } [get_ports { TMDS_IN_data_p[2] }]; #IO_L2P_T0_34 Sch=hdmi_rx_p[2]
set_property src_info {type:XDC file:4 line:71 export:INPUT save:INPUT read:READ} [current_design]
set_property -dict { PACKAGE_PIN U1    IOSTANDARD TMDS_33     } [get_ports { TMDS_OUT_clk_n }]; #IO_L1N_T0_34 Sch=hdmi_tx_clk_n
set_property src_info {type:XDC file:4 line:72 export:INPUT save:INPUT read:READ} [current_design]
set_property -dict { PACKAGE_PIN T1    IOSTANDARD TMDS_33     } [get_ports { TMDS_OUT_clk_p }]; #IO_L1P_T0_34 Sch=hdmi_tx_clk_p
set_property src_info {type:XDC file:4 line:76 export:INPUT save:INPUT read:READ} [current_design]
set_property -dict { PACKAGE_PIN Y1    IOSTANDARD TMDS_33     } [get_ports { TMDS_OUT_data_n[0] }]; #IO_L5N_T0_34 Sch=hdmi_tx_n[0]
set_property src_info {type:XDC file:4 line:77 export:INPUT save:INPUT read:READ} [current_design]
set_property -dict { PACKAGE_PIN W1    IOSTANDARD TMDS_33     } [get_ports { TMDS_OUT_data_p[0] }]; #IO_L5P_T0_34 Sch=hdmi_tx_p[0]
set_property src_info {type:XDC file:4 line:78 export:INPUT save:INPUT read:READ} [current_design]
set_property -dict { PACKAGE_PIN AB1   IOSTANDARD TMDS_33     } [get_ports { TMDS_OUT_data_n[1] }]; #IO_L7N_T1_34 Sch=hdmi_tx_n[1]
set_property src_info {type:XDC file:4 line:79 export:INPUT save:INPUT read:READ} [current_design]
set_property -dict { PACKAGE_PIN AA1   IOSTANDARD TMDS_33     } [get_ports { TMDS_OUT_data_p[1] }]; #IO_L7P_T1_34 Sch=hdmi_tx_p[1]
set_property src_info {type:XDC file:4 line:80 export:INPUT save:INPUT read:READ} [current_design]
set_property -dict { PACKAGE_PIN AB2   IOSTANDARD TMDS_33     } [get_ports { TMDS_OUT_data_n[2] }]; #IO_L8N_T1_34 Sch=hdmi_tx_n[2]
set_property src_info {type:XDC file:4 line:81 export:INPUT save:INPUT read:READ} [current_design]
set_property -dict { PACKAGE_PIN AB3   IOSTANDARD TMDS_33     } [get_ports { TMDS_OUT_data_p[2] }]; #IO_L8P_T1_34 Sch=hdmi_tx_p[2]
set_property src_info {type:XDC file:4 line:93 export:INPUT save:INPUT read:READ} [current_design]
set_property -dict { PACKAGE_PIN T4    IOSTANDARD LVCMOS33 } [get_ports { SDATA_I }]; #IO_L13N_T2_MRCC_34 Sch=ac_adc_sdata
set_property src_info {type:XDC file:4 line:94 export:INPUT save:INPUT read:READ} [current_design]
set_property -dict { PACKAGE_PIN T5    IOSTANDARD LVCMOS33 } [get_ports { BCLK_O }]; #IO_L14P_T2_SRCC_34 Sch=ac_bclk
set_property src_info {type:XDC file:4 line:95 export:INPUT save:INPUT read:READ} [current_design]
set_property -dict { PACKAGE_PIN W6    IOSTANDARD LVCMOS33 } [get_ports { SDATA_O }]; #IO_L15P_T2_DQS_34 Sch=ac_dac_sdata
set_property src_info {type:XDC file:4 line:96 export:INPUT save:INPUT read:READ} [current_design]
set_property -dict { PACKAGE_PIN U5    IOSTANDARD LVCMOS33 } [get_ports { LRCLK_O }]; #IO_L14N_T2_SRCC_34 Sch=ac_lrclk
set_property src_info {type:XDC file:4 line:97 export:INPUT save:INPUT read:READ} [current_design]
set_property -dict { PACKAGE_PIN U6    IOSTANDARD LVCMOS33 } [get_ports { MCLK_O }]; #IO_L16P_T2_34 Sch=ac_mclk
set_property src_info {type:XDC file:4 line:101 export:INPUT save:INPUT read:READ} [current_design]
set_property -dict { PACKAGE_PIN AB22  IOSTANDARD LVCMOS33 } [get_ports { ss }]; #IO_L10N_T1_D15_14 Sch=ja[1]
set_property src_info {type:XDC file:4 line:102 export:INPUT save:INPUT read:READ} [current_design]
set_property -dict { PACKAGE_PIN AB21  IOSTANDARD LVCMOS33 } [get_ports { mosi }]; #IO_L10P_T1_D14_14 Sch=ja[2]
set_property src_info {type:XDC file:4 line:103 export:INPUT save:INPUT read:READ} [current_design]
set_property -dict { PACKAGE_PIN AB20  IOSTANDARD LVCMOS33 } [get_ports { miso }]; #IO_L15N_T2_DQS_DOUT_CSO_B_14 Sch=ja[3]
set_property src_info {type:XDC file:4 line:104 export:INPUT save:INPUT read:READ} [current_design]
set_property -dict { PACKAGE_PIN AB18  IOSTANDARD LVCMOS33 } [get_ports { sclk }]; #IO_L17N_T2_A13_D29_14 Sch=ja[4]
set_property src_info {type:XDC file:4 line:113 export:INPUT save:INPUT read:READ} [current_design]
set_property -dict { PACKAGE_PIN V8    IOSTANDARD LVCMOS33 } [get_ports { PWM }]; #IO_L21N_T3_DQS_34 Sch=jb_n[1]
set_property src_info {type:XDC file:4 line:114 export:INPUT save:INPUT read:READ} [current_design]
set_property -dict { PACKAGE_PIN V7    IOSTANDARD LVCMOS33 } [get_ports { DIR_2 }]; #IO_L19P_T3_34 Sch=jb_p[2]
set_property src_info {type:XDC file:4 line:115 export:INPUT save:INPUT read:READ} [current_design]
set_property -dict { PACKAGE_PIN W7    IOSTANDARD LVCMOS33 } [get_ports { DIR_1 }]; #IO_L19N_T3_VREF_34 Sch=jb_n[2]
set_property src_info {type:XDC file:4 line:118 export:INPUT save:INPUT read:READ} [current_design]
set_property -dict { PACKAGE_PIN Y8    IOSTANDARD LVCMOS33 } [get_ports { ENC_2 }]; #IO_L23P_T3_34 Sch=jb_p[4]
set_property src_info {type:XDC file:4 line:119 export:INPUT save:INPUT read:READ} [current_design]
set_property -dict { PACKAGE_PIN Y7    IOSTANDARD LVCMOS33 } [get_ports { ENC_1 }]; #IO_L23N_T3_34 Sch=jb_n[4]
set_property src_info {type:XDC file:4 line:204 export:INPUT save:INPUT read:READ} [current_design]
set_property -dict { PACKAGE_PIN W5    IOSTANDARD LVCMOS33 } [get_ports { iic_rtl_scl_io }]; #IO_L15N_T2_DQS_34 Sch=scl
set_property src_info {type:XDC file:4 line:205 export:INPUT save:INPUT read:READ} [current_design]
set_property -dict { PACKAGE_PIN V5    IOSTANDARD LVCMOS33 } [get_ports { iic_rtl_sda_io }]; #IO_L16N_T2_34 Sch=sda
set_property src_info {type:SCOPED_XDC file:5 line:5 export:INPUT save:INPUT read:READ} [current_design]
set_max_delay -from [get_clocks -of_objects [get_pins hdmi_i/v_tc_0/U0/clk]] -to [all_registers -clock [get_clocks -of_objects [get_pins hdmi_i/v_tc_0/U0/s_axi_aclk]]] -datapath_only [get_property -min PERIOD [get_clocks -of_objects [get_pins hdmi_i/v_tc_0/U0/clk]]]
set_property src_info {type:SCOPED_XDC file:5 line:6 export:INPUT save:INPUT read:READ} [current_design]
set_max_delay -from [get_clocks -of_objects [get_pins hdmi_i/v_tc_0/U0/s_axi_aclk]] -to [all_registers -clock [get_clocks -of_objects [get_pins hdmi_i/v_tc_0/U0/clk]]] -datapath_only [get_property -min PERIOD [get_clocks -of_objects [get_pins hdmi_i/v_tc_0/U0/s_axi_aclk]]]
set_property src_info {type:SCOPED_XDC file:6 line:5 export:INPUT save:INPUT read:READ} [current_design]
set_max_delay -from [get_clocks -of_objects [get_pins hdmi_i/v_tc_1/U0/clk]] -to [all_registers -clock [get_clocks -of_objects [get_pins hdmi_i/v_tc_1/U0/s_axi_aclk]]] -datapath_only [get_property -min PERIOD [get_clocks -of_objects [get_pins hdmi_i/v_tc_1/U0/clk]]]
set_property src_info {type:SCOPED_XDC file:6 line:6 export:INPUT save:INPUT read:READ} [current_design]
set_max_delay -from [get_clocks -of_objects [get_pins hdmi_i/v_tc_1/U0/s_axi_aclk]] -to [all_registers -clock [get_clocks -of_objects [get_pins hdmi_i/v_tc_1/U0/clk]]] -datapath_only [get_property -min PERIOD [get_clocks -of_objects [get_pins hdmi_i/v_tc_1/U0/s_axi_aclk]]]
set_property src_info {type:SCOPED_XDC file:7 line:10 export:INPUT save:INPUT read:READ} [current_design]
set_max_delay -from [get_cells COUPLER_INST/FIFO_INST/inst_fifo_gen/gconvfifo.rf/grf.rf/gntv_or_sync_fifo.gcx.clkx/rd_pntr_gc_reg[*]] -to [get_cells COUPLER_INST/FIFO_INST/inst_fifo_gen/gconvfifo.rf/grf.rf/gntv_or_sync_fifo.gcx.clkx/gsync_stage[*].wr_stg_inst/Q_reg_reg[*]] -datapath_only [get_property -min PERIOD [get_clocks -of_objects [get_pins hdmi_i/v_vid_in_axi4s_0/inst/aclk]]]
set_property src_info {type:SCOPED_XDC file:7 line:11 export:INPUT save:INPUT read:READ} [current_design]
set_max_delay -from [get_cells COUPLER_INST/FIFO_INST/inst_fifo_gen/gconvfifo.rf/grf.rf/gntv_or_sync_fifo.gcx.clkx/wr_pntr_gc_reg[*]] -to [get_cells COUPLER_INST/FIFO_INST/inst_fifo_gen/gconvfifo.rf/grf.rf/gntv_or_sync_fifo.gcx.clkx/gsync_stage[*].rd_stg_inst/Q_reg_reg[*]] -datapath_only [get_property -min PERIOD [get_clocks -of_objects [get_pins hdmi_i/v_vid_in_axi4s_0/inst/vid_io_in_clk]]]
set_property src_info {type:SCOPED_XDC file:8 line:59 export:INPUT save:INPUT read:READ} [current_design]
set_max_delay -from [get_cells inst_fifo_gen/gconvfifo.rf/grf.rf/gntv_or_sync_fifo.gcx.clkx/rd_pntr_gc_reg[*]] -to [get_cells inst_fifo_gen/gconvfifo.rf/grf.rf/gntv_or_sync_fifo.gcx.clkx/gsync_stage[*].wr_stg_inst/Q_reg_reg[*]] -datapath_only [get_property -min PERIOD [get_clocks -of_objects [get_pins hdmi_i/d_axi_i2s_audio_0/U0/d_axi_i2s_audio_v2_0_AXI_L_inst/Inst_I2sCtl/Inst_I2sTxFifo/U0/rd_clk]]]
set_property src_info {type:SCOPED_XDC file:8 line:61 export:INPUT save:INPUT read:READ} [current_design]
set_max_delay -from [get_cells inst_fifo_gen/gconvfifo.rf/grf.rf/gntv_or_sync_fifo.gcx.clkx/wr_pntr_gc_reg[*]] -to [get_cells inst_fifo_gen/gconvfifo.rf/grf.rf/gntv_or_sync_fifo.gcx.clkx/gsync_stage[*].rd_stg_inst/Q_reg_reg[*]] -datapath_only [get_property -min PERIOD [get_clocks -of_objects [get_pins hdmi_i/d_axi_i2s_audio_0/U0/d_axi_i2s_audio_v2_0_AXI_L_inst/Inst_I2sCtl/Inst_I2sTxFifo/U0/wr_clk]]]
set_property src_info {type:SCOPED_XDC file:9 line:59 export:INPUT save:INPUT read:READ} [current_design]
set_max_delay -from [get_cells inst_fifo_gen/gconvfifo.rf/grf.rf/gntv_or_sync_fifo.gcx.clkx/rd_pntr_gc_reg[*]] -to [get_cells inst_fifo_gen/gconvfifo.rf/grf.rf/gntv_or_sync_fifo.gcx.clkx/gsync_stage[*].wr_stg_inst/Q_reg_reg[*]] -datapath_only [get_property -min PERIOD [get_clocks -of_objects [get_pins hdmi_i/d_axi_i2s_audio_0/U0/d_axi_i2s_audio_v2_0_AXI_L_inst/Inst_I2sCtl/Inst_I2sRxFifo/U0/rd_clk]]]
set_property src_info {type:SCOPED_XDC file:9 line:61 export:INPUT save:INPUT read:READ} [current_design]
set_max_delay -from [get_cells inst_fifo_gen/gconvfifo.rf/grf.rf/gntv_or_sync_fifo.gcx.clkx/wr_pntr_gc_reg[*]] -to [get_cells inst_fifo_gen/gconvfifo.rf/grf.rf/gntv_or_sync_fifo.gcx.clkx/gsync_stage[*].rd_stg_inst/Q_reg_reg[*]] -datapath_only [get_property -min PERIOD [get_clocks -of_objects [get_pins hdmi_i/d_axi_i2s_audio_0/U0/d_axi_i2s_audio_v2_0_AXI_L_inst/Inst_I2sCtl/Inst_I2sRxFifo/U0/wr_clk]]]
set_property src_info {type:SCOPED_XDC file:10 line:59 export:INPUT save:INPUT read:READ} [current_design]
set_max_delay -from [get_cells inst_fifo_gen/gconvfifo.rf/grf.rf/gntv_or_sync_fifo.gcx.clkx/rd_pntr_gc_reg[*]] -to [get_cells inst_fifo_gen/gconvfifo.rf/grf.rf/gntv_or_sync_fifo.gcx.clkx/gsync_stage[*].wr_stg_inst/Q_reg_reg[*]] -datapath_only [get_property -min PERIOD [get_clocks -of_objects [get_pins hdmi_i/d_axi_i2s_audio_0/U0/d_axi_i2s_audio_v2_0_AXI_L_inst/Inst_I2sCtl/Inst_Sampling/U0/rd_clk]]]
set_property src_info {type:SCOPED_XDC file:10 line:61 export:INPUT save:INPUT read:READ} [current_design]
set_max_delay -from [get_cells inst_fifo_gen/gconvfifo.rf/grf.rf/gntv_or_sync_fifo.gcx.clkx/wr_pntr_gc_reg[*]] -to [get_cells inst_fifo_gen/gconvfifo.rf/grf.rf/gntv_or_sync_fifo.gcx.clkx/gsync_stage[*].rd_stg_inst/Q_reg_reg[*]] -datapath_only [get_property -min PERIOD [get_clocks -of_objects [get_pins hdmi_i/d_axi_i2s_audio_0/U0/d_axi_i2s_audio_v2_0_AXI_L_inst/Inst_I2sCtl/Inst_Sampling/U0/wr_clk]]]
