emilkarimov/G3_airhockey/src/image_proc/NexysVideo-master_v3/Projects/hdmi/proj/hdmi.sdk/hdmi_v7_bsp/microblaze_0/include/motor_ip_mar27.h

#ifndef MOTOR_IP_MAR27_H
#define MOTOR_IP_MAR27_H


/****************** Include Files ********************/
#include "xil_types.h"
#include "xstatus.h"

#define MOTOR_IP_MAR27_S00_AXI_SLV_REG0_OFFSET 0
#define MOTOR_IP_MAR27_S00_AXI_SLV_REG1_OFFSET 4
#define MOTOR_IP_MAR27_S00_AXI_SLV_REG2_OFFSET 8
#define MOTOR_IP_MAR27_S00_AXI_SLV_REG3_OFFSET 12
#define MOTOR_IP_MAR27_S00_AXI_SLV_REG4_OFFSET 16
#define MOTOR_IP_MAR27_S00_AXI_SLV_REG5_OFFSET 20
#define MOTOR_IP_MAR27_S00_AXI_SLV_REG6_OFFSET 24
#define MOTOR_IP_MAR27_S00_AXI_SLV_REG7_OFFSET 28
#define MOTOR_IP_MAR27_S00_AXI_SLV_REG8_OFFSET 32
#define MOTOR_IP_MAR27_S00_AXI_SLV_REG9_OFFSET 36
#define MOTOR_IP_MAR27_S00_AXI_SLV_REG10_OFFSET 40
#define MOTOR_IP_MAR27_S00_AXI_SLV_REG11_OFFSET 44


/**************************** Type Definitions *****************************/
/**
 *
 * Write a value to a MOTOR_IP_MAR27 register. A 32 bit write is performed.
 * If the component is implemented in a smaller width, only the least
 * significant data is written.
 *
 * @param   BaseAddress is the base address of the MOTOR_IP_MAR27device.
 * @param   RegOffset is the register offset from the base to write to.
 * @param   Data is the data written to the register.
 *
 * @return  None.
 *
 * @note
 * C-style signature:
 * 	void MOTOR_IP_MAR27_mWriteReg(u32 BaseAddress, unsigned RegOffset, u32 Data)
 *
 */
#define MOTOR_IP_MAR27_mWriteReg(BaseAddress, RegOffset, Data) \
  	Xil_Out32((BaseAddress) + (RegOffset), (u32)(Data))

/**
 *
 * Read a value from a MOTOR_IP_MAR27 register. A 32 bit read is performed.
 * If the component is implemented in a smaller width, only the least
 * significant data is read from the register. The most significant data
 * will be read as 0.
 *
 * @param   BaseAddress is the base address of the MOTOR_IP_MAR27 device.
 * @param   RegOffset is the register offset from the base to write to.
 *
 * @return  Data is the data from the register.
 *
 * @note
 * C-style signature:
 * 	u32 MOTOR_IP_MAR27_mReadReg(u32 BaseAddress, unsigned RegOffset)
 *
 */
#define MOTOR_IP_MAR27_mReadReg(BaseAddress, RegOffset) \
    Xil_In32((BaseAddress) + (RegOffset))

/************************** Function Prototypes ****************************/
/**
 *
 * Run a self-test on the driver/device. Note this may be a destructive test if
 * resets of the device are performed.
 *
 * If the hardware system is not built correctly, this function may never
 * return to the caller.
 *
 * @param   baseaddr_p is the base address of the MOTOR_IP_MAR27 instance to be worked on.
 *
 * @return
 *
 *    - XST_SUCCESS   if all self-test code passed
 *    - XST_FAILURE   if any self-test code failed
 *
 * @note    Caching must be turned off for this function to work.
 * @note    Self test may fail if data memory and device are not on the same bus.
 *
 */
XStatus MOTOR_IP_MAR27_Reg_SelfTest(void * baseaddr_p);

#endif // MOTOR_IP_MAR27_H
