emilkarimov/G3_airhockey/src/image_proc/NexysVideo-master_v3/Projects/hdmi/proj/hdmi.srcs/sources_1/bd/hdmi/ipshared/xilinx.com/packaged_joystick_v1_0/hdl/ssdCtrl.v

`timescale 1ns / 1ps
///////////////////////////////////////////////////////////////////////////////////
// Company: Digilent Inc.
// Engineer: Josh Sackos
// 
// Create Date:    07/11/2012
// Module Name:    ssdCtrl 
// Project Name: 	 PmodJSTK_Demo
// Target Devices: Nexys3
// Tool versions:  ISE 14.1
// Description: This module interfaces the onboard seven segment display (SSD) on
//					 the Nexys3, and formats the data to be displayed.
//
//					 The DIN input is a binary number that gets converted to binary
//					 coded decimals, and is displayed as a 4 digit number on the SSD. The
//					 AN output bus drives the SSD's anodes controling the illumination
//					 of the 4 digits on the SSD.  The SEG output bus drives the cathodes
//					 on the SSD to display different characters.
//
// Revision History: 
// 						Revision 0.01 - File Created (Josh Sackos)
///////////////////////////////////////////////////////////////////////////////////


// ============================================================================== 
// 										  Define Module
// ==============================================================================
module ssdCtrl(
		CLK,
		RST,
		DIN,
		AN,
		SEG
   );


	// ===========================================================================
	// 										Port Declarations
	// ===========================================================================
			input CLK;						// 100Mhz clock
			input RST;						// Reset
			input [9:0] DIN;				// Input data to display
			output [3:0] AN;				// Anodes for seven segment display
			output [6:0] SEG;				// Cathodes for seven segment display
			
			
	// ===========================================================================
	// 							  Parameters, Regsiters, and Wires
	// ===========================================================================

			// Outputs to Seven Segment Display
			reg [3:0] AN = 4'hF;
			reg [6:0] SEG = 7'b0000000;

			// 1 kHz Clock Divider
			parameter cntEndVal = 16'hC350;
			reg [15:0] clkCount = 16'h0000;
			reg DCLK;

			// 2 Bit Counter
			reg [1:0] CNT = 2'b00;

			// Binary to BCD
			wire [15:0] bcdData;

			// Output Data Mux
			reg [3:0] muxData;
			
			

	// ===========================================================================
	// 										Implementation
	// ===========================================================================

			//------------------------------
			//	   Convert Binary to BCD
			//------------------------------
			Binary_To_BCD BtoBCD(
					.CLK(CLK),
					.RST(RST),
					.START(DCLK),
					.BIN(DIN),
					.BCDOUT(bcdData)
			);


			//------------------------------
			//			Output Data Mux
			// Select data to display on SSD
			//------------------------------
			always @(CNT[1], CNT[0], bcdData, RST) begin
					if(RST == 1'b1) begin
							muxData <= 4'b0000;
					end
					else begin
							case (CNT)
									2'b00 : muxData <= bcdData[3:0];
									2'b01 : muxData <= bcdData[7:4];
									2'b10 : muxData <= bcdData[11:8];
									2'b11 : muxData <= bcdData[15:12];
							endcase
					end
			end
			
			
			
			//------------------------------
			//		   Segment Decoder
			// Determines cathode pattern
			//   to display digit on SSD
			//------------------------------
			always @(posedge DCLK) begin
					if(RST == 1'b1) begin
							SEG <= 7'b1000000;
					end
					else begin
							case (muxData)

									4'h0 : SEG <= 7'b1000000;  // 0
									4'h1 : SEG <= 7'b1111001;  // 1
									4'h2 : SEG <= 7'b0100100;  // 2
									4'h3 : SEG <= 7'b0110000;  // 3
									4'h4 : SEG <= 7'b0011001;  // 4
									4'h5 : SEG <= 7'b0010010;  // 5
									4'h6 : SEG <= 7'b0000010;  // 6
									4'h7 : SEG <= 7'b1111000;  // 7
									4'h8 : SEG <= 7'b0000000;  // 8
									4'h9 : SEG <= 7'b0010000;  // 9
									default : SEG <= 7'b1000000;
									
							endcase
					end
			end



			//---------------------------------
			//	  		  Anode Decoder
			//    Determines digit digit to
			//   illuminate for clock period
			//---------------------------------
			always @(posedge DCLK) begin
					if(RST == 1'b1) begin
							AN <= 4'b0000;
					end
					else begin
							case (CNT)

									4'h0 : AN <= 7'b1110;  // 0
									4'h1 : AN <= 7'b1101;  // 1
									4'h2 : AN <= 7'b1011;  // 2
									4'h3 : AN <= 7'b0111;  // 3
									default : AN <= 4'b1111;
									
							endcase
					end
			end	
			

			//------------------------------
			//			2 Bit Counter
			//	 Used to select which diigt
			//	  is being illuminated, and
			//	selects data to be displayed
			//------------------------------
			always @(posedge DCLK) begin
					CNT <= CNT + 1'b1;
			end
			
			//------------------------------
			//			1khz Clock Divider
			//  Timing for refreshing the
			//  			 SSD, etc.
			//------------------------------
			always @(posedge CLK) begin

							if(clkCount == cntEndVal) begin
									DCLK <= 1'b1;
									clkCount <= 16'h0000;
							end
							else begin
									DCLK <= 1'b0;
									clkCount <= clkCount + 1'b1;
							end
			end
	

endmodule
