emilkarimov/G3_airhockey/src/image_proc/NexysVideo-master_v3/Projects/hdmi/proj/hdmi.sdk/hdmi_v7/src/video_capture/video_capture.c

/******************************************************************************
 * @file video_capture.c
 * Digilent Video Capture Driver
 *
 * @author Sam Bobrowicz
 *
 * @date 2015-Nov-25
 *
 * @copyright
 * (c) 2015 Copyright Digilent Incorporated
 * All Rights Reserved
 *
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
 * @desciption
 * This module provides an easy to use API for streaming video into memory
 * on a Digilent system board. It currently has only been tested with HDMI
 * input streams, but other video sources such as an image sensor or displayport
 * should work with minor modifications. Current features include seamless
 * framebuffer-swapping, ability to pause/start streaming, and attaching a callback
 * function that is called on video detection and signal loss. The driver can
 * also be configured to automatically start streaming into memory when a video
 * signal is detected.
 *
 * To use this driver you must have a Xilinx Video Timing Controller core (vtc),
 * Xilinx axi_vdma core, Xilinx Video to AXI Stream core, Digilent DVI2RGB core,
 * and an axi_gpio core (for Hot-plug detect and signal lock detection) present
 * in your design. See the Video/Display reference projects for your system board
 * to see how they need to be connected. Digilent reference projects and IP cores
 * can be found at www.github.com/Digilent.
 *
 * <pre>
 * MODIFICATION HISTORY:
 *
 * Ver   Who          Date         Changes
 * ----- ------------ -----------  -----------------------------------------------
 * 1.00  Sam Bobrowicz 2015-Nov-25 First Release
 *
 * </pre>
 *
 *****************************************************************************/
/*
 * TODO: The VDMA debugging options can be enabled in Vivado IPI to enable
 *       the frame count functionality. This provides an interrupt that is
 *       triggered at the end of every frame, and also provides the ability
 *       to grab a single frame and have the VDMA core then automatically
 *       halt. We should evaluate if adding this functionality is worth requiring
 *       users to enable the Debug mode of the VDMA core (it requires some
 *       manual TCL commands to be run).
 * TODO: Currently VDMA errors (typically SOFLate) crop up every time
 *       The stream is started after having been stopped. The error appears to
 *       only be with the first frame that is input, as it goes away when
 *       it is cleared and the stream is still running. This shouldn't
 *       be a problem with the controller now, since we don't have the
 *       ability to just grab a single frame, but if we add frame count
 *       support or a frame finished interrupt then this will likely need
 *       to be addressed.
 * TODO: Make the VTC struct get passed as a pointer so that this driver
 *       will work with designs that share the VTC with a display pipeline
 *       that uses it in generator mode. Will need to test that all accesses
 *       to the VTC don't interfere with generator functionality. Note that
 *       this requires both the Display and Video pipelines use the same
 *       pixel clock.
 * TODO: It would be nice to remove the need for users above this to access
 *       members of the VideoCapture struct manually. This can be done by
 *       implementing get/set functions for things like video timings, state,
 *       current frame, etc..
 */



/* ------------------------------------------------------------ */
/*				Include File Definitions						*/
/* ------------------------------------------------------------ */

/*
 * Uncomment for Debugging messages over UART
 */
//#define DEBUG 1
#include "../../../hdmi_v7_bsp/microblaze_0/include/xil_printf.h"

#include "video_capture.h"
#include "../../../hdmi_v7_bsp/microblaze_0/include/xdebug.h"

/* ------------------------------------------------------------ */
/*				Procedure Definitions							*/
/* ------------------------------------------------------------ */

/***	VideoStop(VideoCapture *videoPtr)
**
**	Parameters:
**		videoPtr - Pointer to the initialized VideoCapture struct
**
**	Return Value: int
**		XST_SUCCESS if successful. Currently always returns success
**
**	Description:
**		Halts input stream into memory
**
*/
int VideoStop(VideoCapture *videoPtr)
{

	/*
	 * If already stopped, do nothing
	 */
	if (videoPtr->state == VIDEO_PAUSED || videoPtr->state == VIDEO_DISCONNECTED)
	{
		return XST_SUCCESS;
	}

	XAxiVdma_Reset(videoPtr->vdma, XAXIVDMA_WRITE);
	while(XAxiVdma_ResetNotDone(videoPtr->vdma, XAXIVDMA_WRITE));
	videoPtr->state = VIDEO_PAUSED;

	return XST_SUCCESS;
}
/* ------------------------------------------------------------ */

/***	VideoStart(VideoCapture *videoPtr)
**
**	Parameters:
**		videoPtr - Pointer to the initialized VideoCapture struct
**
**	Return Value: int
**		XST_SUCCESS if successful
**		XST_NO_DATA if the Video input is disconnected
**		XST_FAILURE otherwise
**
**	Errors:
**
**	Description:
**		Starts writing the Video stream into memory.
**
*/
int VideoStart(VideoCapture *videoPtr)
{
	int Status;
	int i;

	//xil_printf("Video start entered\n\r");
	if (videoPtr->state == VIDEO_DISCONNECTED)
		return XST_NO_DATA;
	if (videoPtr->state == VIDEO_STREAMING)
		return XST_SUCCESS;

	/*
	 * Configure the VDMA to access a frame with the same dimensions as the
	 * current mode
	 */
	videoPtr->vdmaConfig.VertSizeInput = videoPtr->timing.VActiveVideo;
	videoPtr->vdmaConfig.HoriSizeInput = videoPtr->timing.HActiveVideo * 3;
	videoPtr->vdmaConfig.FixedFrameStoreAddr = videoPtr->curFrame;
	/*
	 *Also reset the stride and address values, in case the user manually changed them
	 */
	videoPtr->vdmaConfig.Stride = videoPtr->stride;
	for (i = 0; i < VIDEO_NUM_FRAMES; i++)
	{
		videoPtr->vdmaConfig.FrameStoreStartAddr[i] = (u32)  videoPtr->framePtr[i];
	}

	xdbg_printf(XDBG_DEBUG_GENERAL, "Starting VDMA for Video capture\n\r");
	Status = XAxiVdma_DmaConfig(videoPtr->vdma, XAXIVDMA_WRITE, &(videoPtr->vdmaConfig));
	if (Status != XST_SUCCESS)
	{
		xdbg_printf(XDBG_DEBUG_GENERAL, "Write channel config failed %d\r\n", Status);
		return XST_FAILURE;
	}
	Status = XAxiVdma_DmaSetBufferAddr(videoPtr->vdma, XAXIVDMA_WRITE, videoPtr->vdmaConfig.FrameStoreStartAddr);
	if (Status != XST_SUCCESS)
	{
		xdbg_printf(XDBG_DEBUG_GENERAL, "Write channel set buffer address failed %d\r\n", Status);
		return XST_FAILURE;
	}
	Status = XAxiVdma_DmaStart(videoPtr->vdma, XAXIVDMA_WRITE);
	if (Status != XST_SUCCESS)
	{
		xdbg_printf(XDBG_DEBUG_GENERAL, "Start Write transfer failed %d\r\n", Status);
		return XST_FAILURE;
	}
	Status = XAxiVdma_StartParking(videoPtr->vdma, videoPtr->curFrame, XAXIVDMA_WRITE);
	if (Status != XST_SUCCESS)
	{
		xdbg_printf(XDBG_DEBUG_GENERAL, "Unable to park the Write channel %d\r\n", Status);
		return XST_FAILURE;
	}

	videoPtr->state = VIDEO_STREAMING;

	return XST_SUCCESS;
}

/* ------------------------------------------------------------ */

/***	VideoInitialize(VideoCapture *videoPtr, INTC *intCtrl, XAxiVdma *vdma, u16 gpioId, u16 vtcId, u32 vtcIrptId, u8 *framePtr[VIDEO_NUM_FRAMES], u32 stride, u32 startOnDet)

**
**	Parameters:
**		videoPtr - Pointer to the struct that will be initialized
**		intCtrl - pointer to the initialized interrupt controller. Prior to calling this function, the interrupt
**				  controller must be initialized and enabled using the Digilent intc library. The vector table must also
**				  include entries for the VTC controller and AXI GPIO used with this driver. You can use the videoGpioIvt and
**				  videoVtcIvt Macros for creating the vector table entries.
**		vdma - Pointer to the initialized VDMA driver struct.
**		gpioId - Device ID of the AXI GPIO core as found in xparameters.h. This is the core connect to the HPD and locked signals
**		vtcId - Device ID of the VTC core as found in xparameters.h
**		vtcIrptId - Interrupt ID of the VTC core
**		framePtr - array of pointers to the framebuffers. The framebuffers must be instantiated above this driver
**		stride - line stride of the framebuffers. This is the number of bytes between the start of one line and the start of another.
**		startOnDet - Flag indicating if you want to begin streaming as soon as a video signal is detected. Non-zero values mean yes.
**
**	Return Value: int
**		XST_SUCCESS if successful, XST_FAILURE otherwise
**
**	Errors:
**
**	Description:
**		Initializes the driver struct for use. The interrupt controller should be enabled before calling this function to ensure
**		a locked interrupt is not missed. After this function has been called, VideoStart,VideoStop, VideoSetCallBack, and VideoChangeFrame
**		can all be called at will.
**
*/
int VideoInitialize(VideoCapture *videoPtr, INTC *intCtrl, XAxiVdma *vdma, u16 gpioId, u16 vtcId, u32 vtcIrptId, u8 *framePtr[VIDEO_NUM_FRAMES], u32 stride, u32 startOnDet)
{
	int Status;
	int i;

	/*
	 * Initialize all the fields in the VideoCapture struct
	 */
	videoPtr->curFrame = 0;
	for (i = 0; i < VIDEO_NUM_FRAMES; i++)
	{
		videoPtr->framePtr[i] = framePtr[i];
	}
	videoPtr->state = VIDEO_DISCONNECTED;
	videoPtr->stride = stride;

	videoPtr->vtcId = vtcId;
	videoPtr->vtcIrptId = vtcIrptId;
	videoPtr->intc = intCtrl;
	videoPtr->vdma = vdma;
	videoPtr->startOnDetect = startOnDet;
	videoPtr->callBack = NULL;
	videoPtr->callBackRef = NULL;

	/*
	 * Initialize the VDMA Read configuration struct
	 */
	videoPtr->vdmaConfig.FrameDelay = 0;
	videoPtr->vdmaConfig.EnableCircularBuf = 1;
	videoPtr->vdmaConfig.EnableSync = 0;
	videoPtr->vdmaConfig.PointNum = 0;
	videoPtr->vdmaConfig.EnableFrameCounter = 0;

	/* Initialize the GPIO driver. If an error occurs then exit */

	xdbg_printf(XDBG_DEBUG_GENERAL, "Video Init startedxv\n\r");
	Status = XGpio_Initialize(&videoPtr->gpio, gpioId);
	if (Status != XST_SUCCESS)
	{
		xdbg_printf(XDBG_DEBUG_GENERAL, "XGPIO Init failed\n\r");
		return XST_FAILURE;
	}

	/*
	 * Perform a self-test on the GPIO.  This is a minimal test and only
	 * verifies that there is not any bus error when reading the data
	 * register
	 */
	XGpio_SelfTest(&videoPtr->gpio);

	/*
	 * Setup direction registers, and ensure HPD is low
	 */
	XGpio_DiscreteWrite(&videoPtr->gpio, 1, 0);
	XGpio_SetDataDirection(&videoPtr->gpio, 1, 0); //Set HPD channel as output
	XGpio_SetDataDirection(&videoPtr->gpio, 2, 1); //Set Locked channel as input


	/*
	 * Enable the GPIO channel interrupts so that push button can be
	 * detected and enable interrupts for the GPIO device
	 */
	XGpio_InterruptEnable(&videoPtr->gpio, XGPIO_IR_CH2_MASK);

	/*
	 * TODO: Consider adding code here to check if locked is high, and then initialize the VTC if it is high.
	 * 		 The point here would be to handle the case where a HDMI source ignores the HPD signal and is always
	 * 		 transmitting a clock. Currently it is possible that this case will not cause a GPIO interrupt, and
	 * 		 therefore the VTC will never get initialized. Probably could just get away with setting the GPIO irpt flag
	 */

	XGpio_InterruptGlobalEnable(&videoPtr->gpio);

	/*
	 * Set HPD high, which will signal the HDMI source to begin transmitting.
	 */
	XGpio_DiscreteWrite(&videoPtr->gpio, 1, 1);
	//xdbg_printf(XDBG_DEBUG_GENERAL, "Video Initialized!\n\r");

	return XST_SUCCESS;
}

/* ------------------------------------------------------------ */

/***	VideoChangeFrame(VideoCapture *videoPtr, u32 frameIndex)
**
**	Parameters:
**		videoPtr - Pointer to the initialized VideoCapture struct
**		frameIndex - Index of the framebuffer to change to (must
**				be between 0 and (DISPLAY_NUM_FRAMES - 1))
**
**	Return Value: int
**		XST_SUCCESS if successful, XST_FAILURE otherwise
**
**	Errors:
**
**	Description:
**		Changes the frame that video is currently streamed to.
**
*/

int VideoChangeFrame(VideoCapture *videoPtr, u32 frameIndex)
{
	int Status;

	videoPtr->curFrame = frameIndex;
	/*
	 * If currently running, then the DMA needs to be told to start reading from the desired frame
	 * at the end of the current frame
	 */
	if (videoPtr->state == VIDEO_STREAMING)
	{
		Status = XAxiVdma_StartParking(videoPtr->vdma, videoPtr->curFrame, XAXIVDMA_WRITE);
		if (Status != XST_SUCCESS)
		{
			xdbg_printf(XDBG_DEBUG_GENERAL, "Cannot change frame, unable to start parking %d\r\n", Status);
			return XST_FAILURE;
		}
	}

	return XST_SUCCESS;
}

/* ------------------------------------------------------------ */

/***	VideoSetCallback(VideoCapture *videoPtr, VideoCallBack CallBackFunc, void *CallBackRef)
**
**	Parameters:
**		videoPtr - Pointer to the initialized VideoCapture struct
**		CallBackFunc - Callback function
**		CallBackRef - Data to pass to callback function
**
**	Return Value:
**
**	Errors:
**
**	Description:
**		Sets the callback function that is called when a video signal
**		is detected or lost. On detection, The VTC Timing struct within the
**		VideoCapture struct will already be updated with the new resolution
**		when the callback is entered.
**
*/
void VideoSetCallback(VideoCapture *videoPtr, VideoCallBack CallBackFunc, void *CallBackRef)
{
	videoPtr->callBackRef = CallBackRef;
	videoPtr->callBack = CallBackFunc;
}

void GpioIsr(void *InstancePtr)
{
	VideoCapture *videoPtr = (VideoCapture *)InstancePtr;
	XGpio *GpioPtr = &videoPtr->gpio;
	u32 locked;
	int Status;
	XVtc_Config *vtcConfig;

	XGpio_InterruptClear(GpioPtr, XGPIO_IR_CH2_MASK);

	locked = XGpio_DiscreteRead(GpioPtr, 2);

	//xil_printf("~");
	if (locked)
	{
		vtcConfig = XVtc_LookupConfig(videoPtr->vtcId);
		if (NULL == vtcConfig)
			return;

		Status = XVtc_CfgInitialize(&(videoPtr->vtc), vtcConfig, vtcConfig->BaseAddress);
		if (Status != (XST_SUCCESS))
			return;

		XVtc_SelfTest(&(videoPtr->vtc));

		XVtc_RegUpdateEnable(&(videoPtr->vtc));
		XVtc_SetCallBack(&(videoPtr->vtc), XVTC_HANDLER_LOCK, VtcIsr, videoPtr);
		XVtc_IntrEnable(&(videoPtr->vtc), 0x100);
		XVtc_EnableDetector(&(videoPtr->vtc));

#ifdef XPAR_INTC_0_DEVICE_ID
		XIntc_Enable(videoPtr->intc, videoPtr->vtcIrptId);
#else
		XScuGic_Enable(videoPtr->intc, videoPtr->vtcIrptId);
#endif
	}
	else
	{
		VideoStop(videoPtr);
		/*
		 * Note the VTC interrupt has to be disabled at the interrupt controller, because the
		 * VTC cannot be accessed here since we don't know if the clock is still
		 * stable. If you try to access any VTC registers when the clock is not
		 * stable then the processor will throw a data abort exception. This is also why we
		 * are disabling the interrupt in the first place, because VtcIsr accesses VTC registers.
		 */
#ifdef XPAR_INTC_0_DEVICE_ID
		XIntc_Disable(videoPtr->intc, videoPtr->vtcIrptId);
#else
		XScuGic_Disable(videoPtr->intc, videoPtr->vtcIrptId);
#endif
		if (videoPtr->callBack != NULL && videoPtr->state != VIDEO_DISCONNECTED)
			videoPtr->callBack(videoPtr->callBackRef, (void *) videoPtr);
		videoPtr->state = VIDEO_DISCONNECTED;
	}
}

void VtcIsr(void *InstancePtr, u32 pendingIrpt)
{
	VideoCapture *videoPtr = (VideoCapture *)InstancePtr;

	//xil_printf( "$");
	if ((XVtc_GetDetectionStatus(&videoPtr->vtc) & XVTC_STAT_LOCKED_MASK))
	{
		XVtc_GetDetectorTiming(&videoPtr->vtc,&videoPtr->timing);
		videoPtr->state = VIDEO_PAUSED;
		if (videoPtr->startOnDetect)
		{
			VideoStart(videoPtr);
		}
		if (videoPtr->callBack != NULL)
			videoPtr->callBack(videoPtr->callBackRef, (void *) videoPtr);
		XVtc_IntrDisable(&(videoPtr->vtc), 0x100);
		XVtc_IntrClear(&(videoPtr->vtc), 0x100);
	}

}

/************************************************************************/
