emilkarimov/G3_airhockey/src/image_proc/NexysVideo-master_v3/Projects/hdmi/proj/hdmi.srcs/sources_1/bd/hdmi/ip/hdmi_ila_0_0/synth/hdmi_ila_0_0.vhd

-- (c) Copyright 1995-2012 Xilinx, Inc. All rights reserved.
--
-- This file contains confidential and proprietary information
-- of Xilinx, Inc. and is protected under U.S. and
-- international copyright and other intellectual property
-- laws.
--
-- DISCLAIMER
-- This disclaimer is not a license and does not grant any
-- rights to the materials distributed herewith. Except as
-- otherwise provided in a valid license issued to you by
-- Xilinx, and to the maximum extent permitted by applicable
-- law: (1) THESE MATERIALS ARE MADE AVAILABLE "AS IS" AND
-- WITH ALL FAULTS, AND XILINX HEREBY DISCLAIMS ALL WARRANTIES
-- AND CONDITIONS, EXPRESS, IMPLIED, OR STATUTORY, INCLUDING
-- BUT NOT LIMITED TO WARRANTIES OF MERCHANTABILITY, NON-
-- INFRINGEMENT, OR FITNESS FOR ANY PARTICULAR PURPOSE; and
-- (2) Xilinx shall not be liable (whether in contract or tort,
-- including negligence, or under any other theory of
-- liability) for any loss or damage of any kind or nature
-- related to, arising under or in connection with these
-- materials, including for any direct, or any indirect,
-- special, incidental, or consequential loss or damage
-- (including loss of data, profits, goodwill, or any type of
-- loss or damage suffered as a result of any action brought
-- by a third party) even if such damage or loss was
-- reasonably foreseeable or Xilinx had been advised of the
-- possibility of the same.
--
-- CRITICAL APPLICATIONS
-- Xilinx products are not designed or intended to be fail-
-- safe, or for use in any application requiring fail-safe
-- performance, such as life-support or safety devices or
-- systems, Class III medical devices, nuclear facilities,
-- applications related to the deployment of airbags, or any
-- other applications that could lead to death, personal
-- injury, or severe property or environmental damage
-- (individually and collectively, "Critical
-- Applications"). Customer assumes the sole risk and
-- liability of any use of Xilinx products in Critical
-- Applications, subject only to applicable laws and
-- regulations governing limitations on product liability.
--
-- THIS COPYRIGHT NOTICE AND DISCLAIMER MUST BE RETAINED AS
-- PART OF THIS FILE AT ALL TIMES.
--
-- DO NOT MODIFY THIS FILE.

LIBRARY ieee;
USE ieee.std_logic_1164.ALL;
USE ieee.numeric_std.ALL;

ENTITY hdmi_ila_0_0 IS
PORT (
clk : IN STD_LOGIC;


probe0 : IN STD_LOGIC_VECTOR(31 DOWNTO 0);
    probe1 : IN STD_LOGIC_VECTOR(31 DOWNTO 0);
    probe2 : IN STD_LOGIC_VECTOR(31 DOWNTO 0);
    probe3 : IN STD_LOGIC_VECTOR(31 DOWNTO 0);
    probe4 : IN STD_LOGIC_VECTOR(31 DOWNTO 0);
    probe5 : IN STD_LOGIC_VECTOR(31 DOWNTO 0);
    probe6 : IN STD_LOGIC_VECTOR(31 DOWNTO 0);
    probe7 : IN STD_LOGIC_VECTOR(31 DOWNTO 0);
    probe8 : IN STD_LOGIC_VECTOR(31 DOWNTO 0);
    probe9 : IN STD_LOGIC_VECTOR(31 DOWNTO 0);
    probe10 : IN STD_LOGIC_VECTOR(31 DOWNTO 0);
    probe11 : IN STD_LOGIC_VECTOR(31 DOWNTO 0);
    probe12 : IN STD_LOGIC_VECTOR(31 DOWNTO 0);
    probe13 : IN STD_LOGIC_VECTOR(0 DOWNTO 0);
    probe14 : IN STD_LOGIC_VECTOR(0 DOWNTO 0);
    probe15 : IN STD_LOGIC_VECTOR(31 DOWNTO 0);
    probe16 : IN STD_LOGIC_VECTOR(0 DOWNTO 0);
    probe17 : IN STD_LOGIC_VECTOR(0 DOWNTO 0);
    probe18 : IN STD_LOGIC_VECTOR(0 DOWNTO 0);
    probe19 : IN STD_LOGIC_VECTOR(1 DOWNTO 0);
    probe20 : IN STD_LOGIC_VECTOR(0 DOWNTO 0);
    probe21 : IN STD_LOGIC_VECTOR(0 DOWNTO 0);
    probe22 : IN STD_LOGIC_VECTOR(0 DOWNTO 0);
    probe23 : IN STD_LOGIC_VECTOR(0 DOWNTO 0);
    probe24 : IN STD_LOGIC_VECTOR(0 DOWNTO 0);
    probe25 : IN STD_LOGIC_VECTOR(0 DOWNTO 0);
    probe26 : IN STD_LOGIC_VECTOR(31 DOWNTO 0);
    probe27 : IN STD_LOGIC_VECTOR(31 DOWNTO 0);
    probe28 : IN STD_LOGIC_VECTOR(31 DOWNTO 0);
    probe29 : IN STD_LOGIC_VECTOR(31 DOWNTO 0);
    probe30 : IN STD_LOGIC_VECTOR(31 DOWNTO 0)
);
END hdmi_ila_0_0;

ARCHITECTURE hdmi_ila_0_0_arch OF hdmi_ila_0_0 IS
COMPONENT ila_v6_1_1_ila IS
GENERIC (
C_XLNX_HW_PROBE_INFO : STRING;
C_XDEVICEFAMILY : STRING;
C_CORE_TYPE : INTEGER;
C_CORE_INFO1 : INTEGER;
C_CORE_INFO2 : INTEGER;
C_CAPTURE_TYPE : INTEGER;
C_MU_TYPE : INTEGER;
C_TC_TYPE : INTEGER;
C_NUM_OF_PROBES : INTEGER;
C_DATA_DEPTH : INTEGER;
C_MAJOR_VERSION : INTEGER;
C_MINOR_VERSION : INTEGER;
C_BUILD_REVISION : INTEGER;
C_CORE_MAJOR_VER : INTEGER;
C_CORE_MINOR_VER : INTEGER;
C_XSDB_SLAVE_TYPE : INTEGER;
C_NEXT_SLAVE : INTEGER;
C_CSE_DRV_VER : INTEGER;
C_USE_TEST_REG : INTEGER;
C_PIPE_IFACE : INTEGER;
C_RAM_STYLE : STRING;
C_TRIGOUT_EN : INTEGER;
C_TRIGIN_EN : INTEGER;
C_ADV_TRIGGER : INTEGER;
C_EN_DDR_ILA : INTEGER;
C_EN_STRG_QUAL : INTEGER;
C_INPUT_PIPE_STAGES : INTEGER;

C_PROBE0_WIDTH : INTEGER;
C_PROBE1_WIDTH : INTEGER;
C_PROBE2_WIDTH : INTEGER;
C_PROBE3_WIDTH : INTEGER;
C_PROBE4_WIDTH : INTEGER;
C_PROBE5_WIDTH : INTEGER;
C_PROBE6_WIDTH : INTEGER;
C_PROBE7_WIDTH : INTEGER;
C_PROBE8_WIDTH : INTEGER;
C_PROBE9_WIDTH : INTEGER;
C_PROBE10_WIDTH : INTEGER;
C_PROBE11_WIDTH : INTEGER;
C_PROBE12_WIDTH : INTEGER;
C_PROBE13_WIDTH : INTEGER;
C_PROBE14_WIDTH : INTEGER;
C_PROBE15_WIDTH : INTEGER;
C_PROBE16_WIDTH : INTEGER;
C_PROBE17_WIDTH : INTEGER;
C_PROBE18_WIDTH : INTEGER;
C_PROBE19_WIDTH : INTEGER;
C_PROBE20_WIDTH : INTEGER;
C_PROBE21_WIDTH : INTEGER;
C_PROBE22_WIDTH : INTEGER;
C_PROBE23_WIDTH : INTEGER;
C_PROBE24_WIDTH : INTEGER;
C_PROBE25_WIDTH : INTEGER;
C_PROBE26_WIDTH : INTEGER;
C_PROBE27_WIDTH : INTEGER;
C_PROBE28_WIDTH : INTEGER;
C_PROBE29_WIDTH : INTEGER;
C_PROBE30_WIDTH : INTEGER;
C_PROBE31_WIDTH : INTEGER;
C_PROBE32_WIDTH : INTEGER;
C_PROBE33_WIDTH : INTEGER;
C_PROBE34_WIDTH : INTEGER;
C_PROBE35_WIDTH : INTEGER;
C_PROBE36_WIDTH : INTEGER;
C_PROBE37_WIDTH : INTEGER;
C_PROBE38_WIDTH : INTEGER;
C_PROBE39_WIDTH : INTEGER;
C_PROBE40_WIDTH : INTEGER;
C_PROBE41_WIDTH : INTEGER;
C_PROBE42_WIDTH : INTEGER;
C_PROBE43_WIDTH : INTEGER;
C_PROBE44_WIDTH : INTEGER;
C_PROBE45_WIDTH : INTEGER;
C_PROBE46_WIDTH : INTEGER;
C_PROBE47_WIDTH : INTEGER;
C_PROBE48_WIDTH : INTEGER;
C_PROBE49_WIDTH : INTEGER;
C_PROBE50_WIDTH : INTEGER;
C_PROBE51_WIDTH : INTEGER;
C_PROBE52_WIDTH : INTEGER;
C_PROBE53_WIDTH : INTEGER;
C_PROBE54_WIDTH : INTEGER;
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
probe663 : IN STD_LOGIC_VECTOR(0 DOWNTO 0);
probe664 : IN STD_LOGIC_VECTOR(0 DOWNTO 0);
probe665 : IN STD_LOGIC_VECTOR(0 DOWNTO 0);
probe666 : IN STD_LOGIC_VECTOR(0 DOWNTO 0);
probe667 : IN STD_LOGIC_VECTOR(0 DOWNTO 0);
probe668 : IN STD_LOGIC_VECTOR(0 DOWNTO 0);
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
