emilkarimov/G3_airhockey/(notices)

Notices in the files:
src/image_proc/NexysVideo-master_v3/Projects/hdmi/proj/hdmi.sdk/hdmi_v7/src/video_capture/video_capture.c:
license ("Revised BSD License", "New BSD License", or "Modified BSD License")
